Cirromulus/tuning-fork-clock/doc/face.jpg

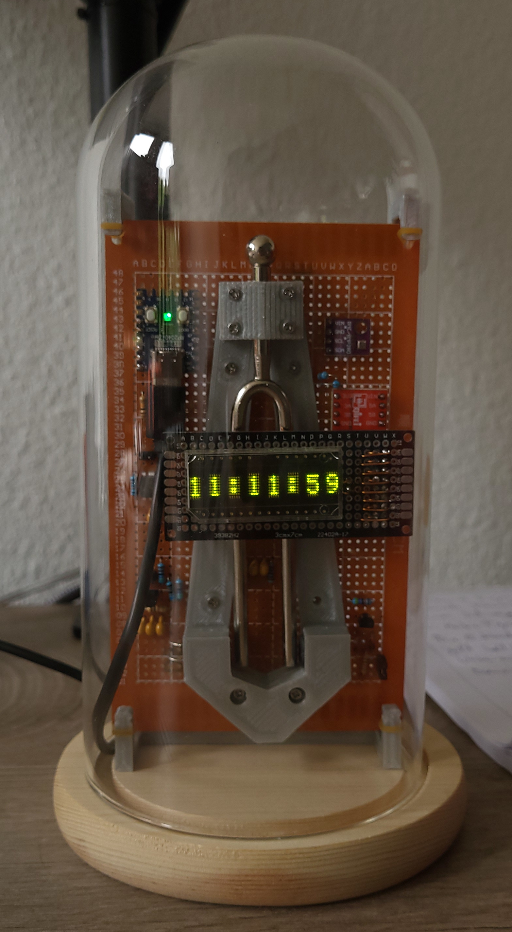
doc/face.jpg
