Cirromulus/tuning-fork-clock/doc/5_day_capture.png

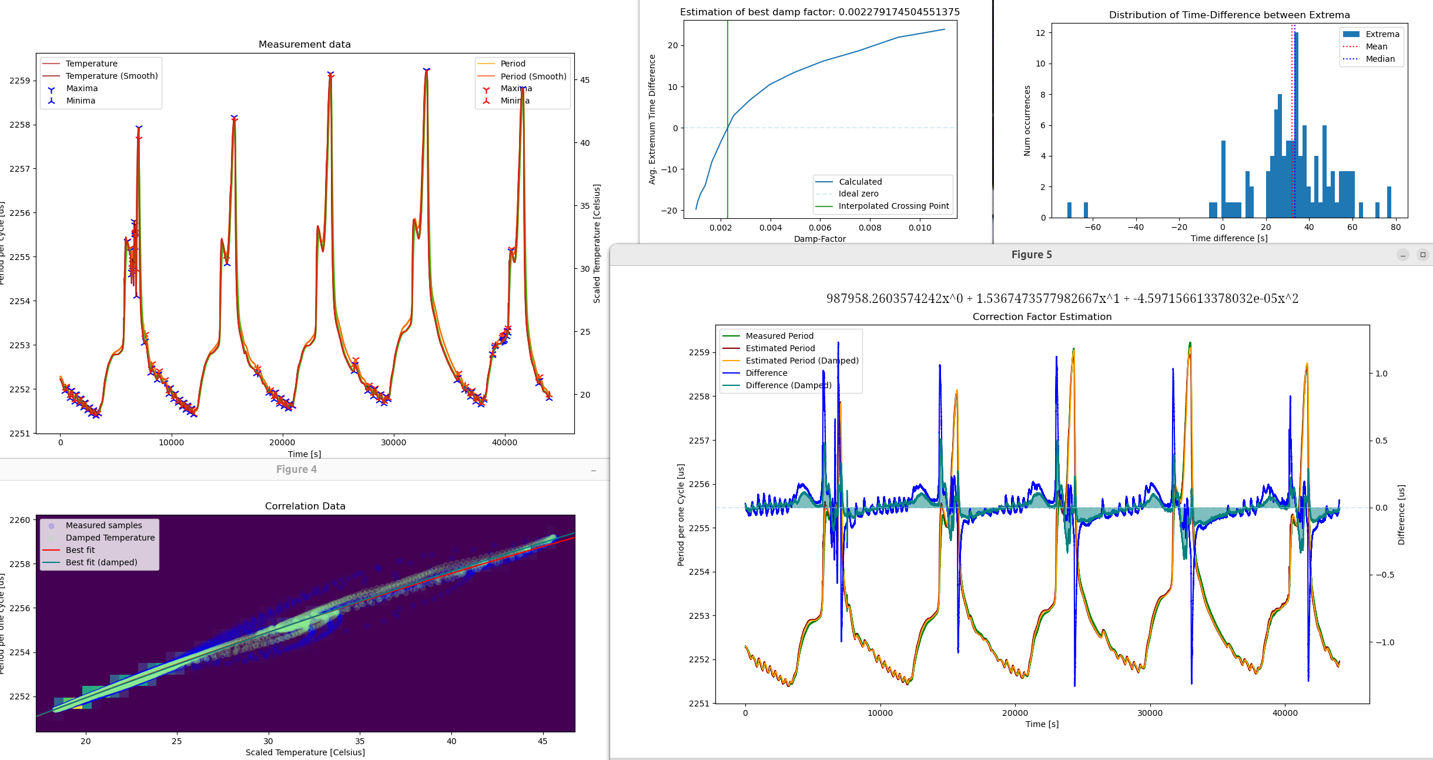
doc/5_day_capture.png
