Cirromulus/tuning-fork-clock/doc/model_training.png

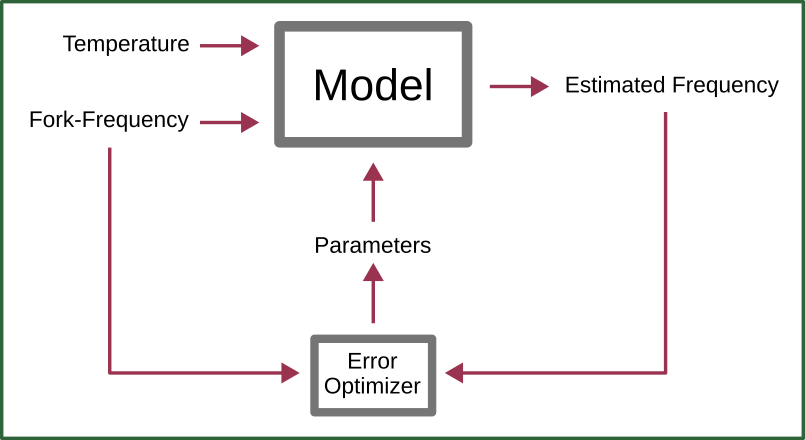
doc/model_training.png
