Cirromulus/tuning-fork-clock/model/Tuningforkholder_base.stl

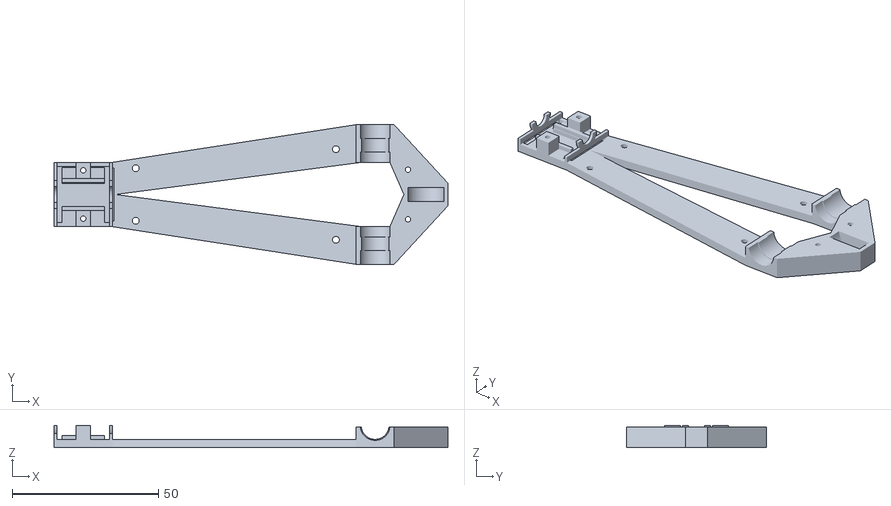
[picture p4: CAD file, 2026-03-09]
model/Tuningforkholder_base.stl
134.9 x 47.8 x 7.55
