Cirromulus/tuning-fork-clock/model/Tuningforkholder_all.stl

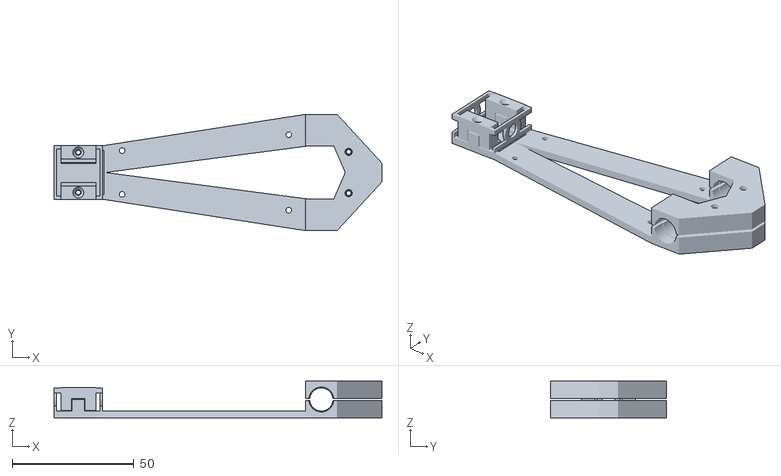
[picture p5: CAD file, 2026-03-09]
model/Tuningforkholder_all.stl
134.9 x 47.8 x 15.1
