Cirromulus/tuning-fork-clock/model/Tuningforkholder_top.stl

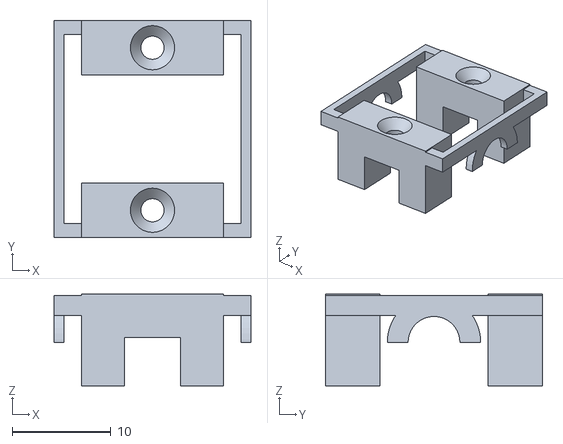
[picture p6: CAD file, 2026-03-09]
model/Tuningforkholder_top.stl
20.0 x 22.0 x 9.32
