Cirromulus/tuning-fork-clock/model/Baseplate_and_holder_normal.stl

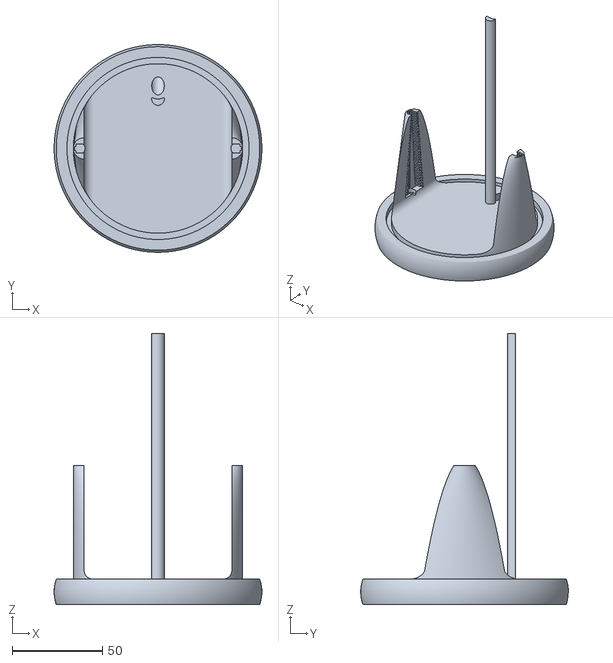
[picture p7: CAD file, 2025-11-26]
model/Baseplate_and_holder_normal.stl
115.0 x 114.9 x 150.0
