Cirromulus/tuning-fork-clock/model/Baseplate_and_holder_tpu.stl

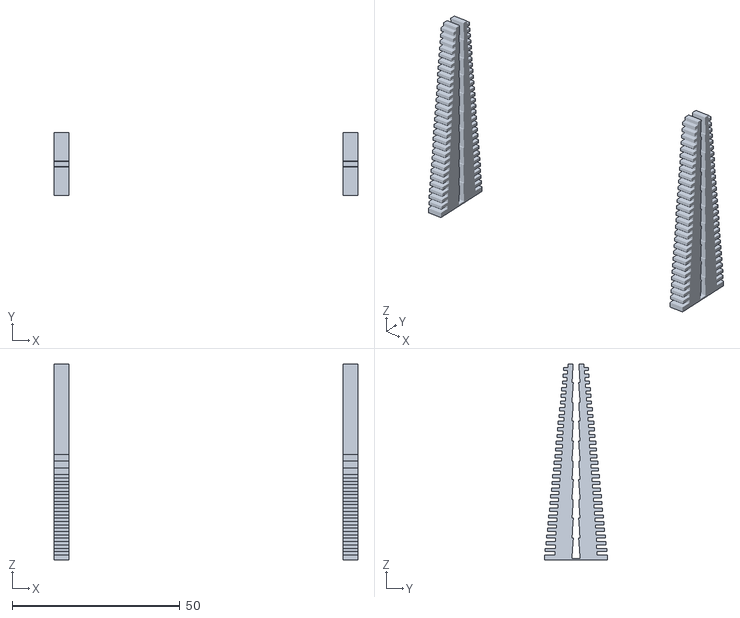
[picture p8: CAD file, 2025-11-26]
model/Baseplate_and_holder_tpu.stl
90.8 x 18.8 x 58.5
