Cirromulus/tuning-fork-clock/model/Stand_v2.FCStd

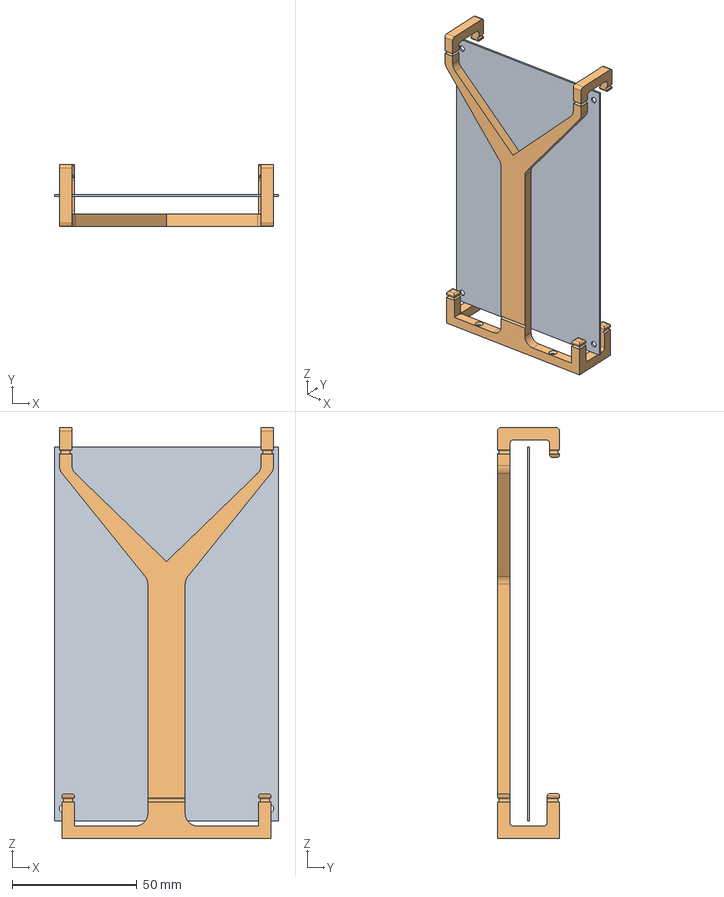
[picture p9: CAD file, 2025-05-02]
model/Stand_v2.FCStd
90.0 x 25.0 x 164.8 mm
Platine
Ständer
