Cirromulus/tuning-fork-clock/model/Stand_v2-Ständer.3mf

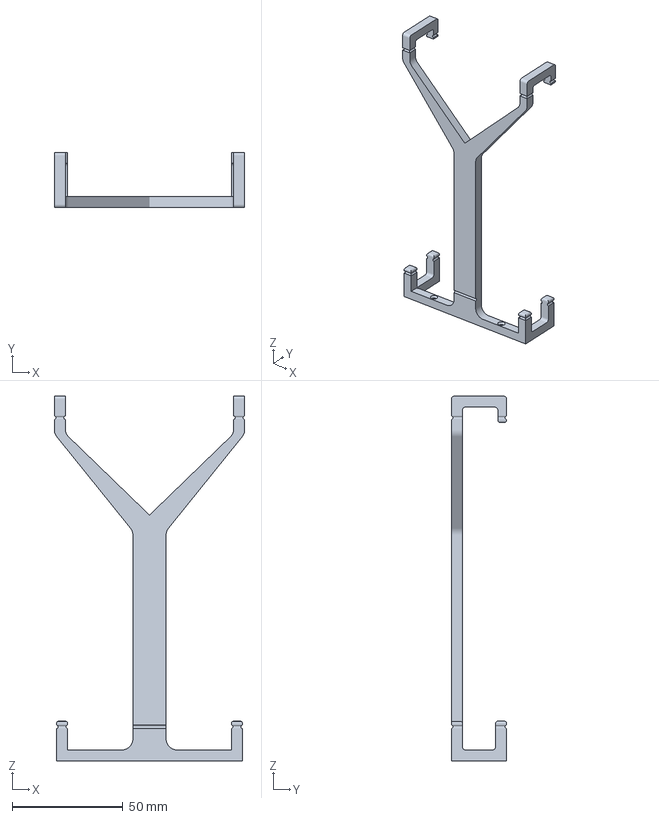
[picture p10: CAD file, 2025-04-27]
model/Stand_v2-Ständer.3mf
86.0 x 25.0 x 164.8 mm
