Cirromulus/tuning-fork-clock/model/Tuningforkholder_bottom.stl

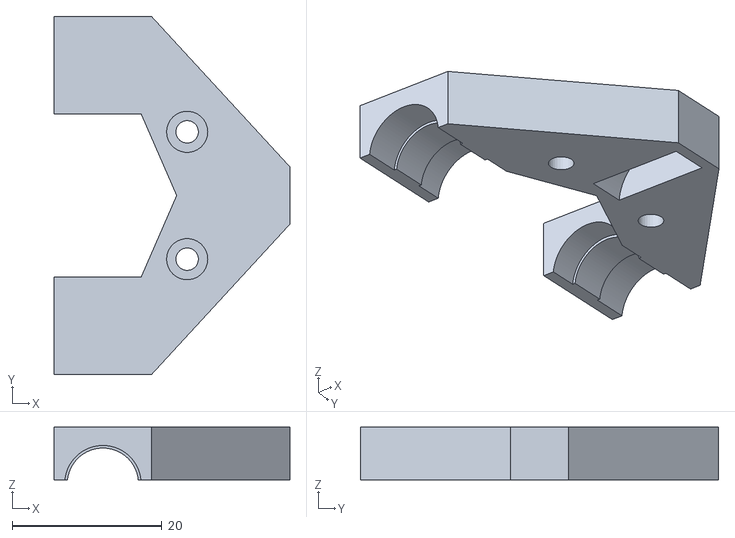
[picture p11: CAD file, 2025-03-22]
model/Tuningforkholder_bottom.stl
31.4 x 47.8 x 7.05
