Cirromulus/tuning-fork-clock/model/Stand.FCStd

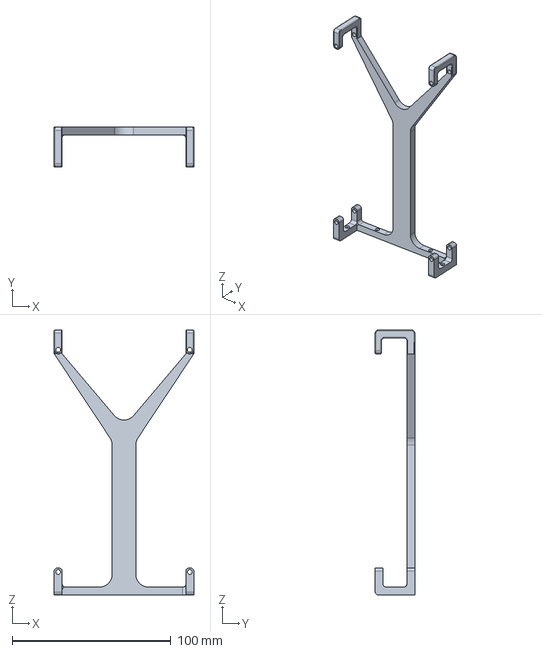
[picture p12: CAD file, 2025-03-30, an earlier design]
model/Stand.FCStd
88.0 x 25.0 x 167.0 mm
