Cirromulus/tuning-fork-clock/model/Tuningforkholder.scad

fork_abstand = 17;
fork_l = 123;
fork_arm_d = 5;
fork_hals_d = 5.5;
fork_hals_l = 40;
fork_hals_sphere = 9;
magnet = [12+.3,4.6+.3];
spule = [10.2, 9.5, 14];

screw_d = 2.1;
screw_head = [5.5, 0, 2];
ws = 1.4;
slot_h = 1;
mounting_height = magnet.x/2 + ws;
conn_h = 2*ws;
main_holder_extra_slit = .33;

show = "all";	//all, base, top, bottom

module fork() {
	round_part_h = ((fork_abstand-fork_hals_d)/2);
	translate([0,0,fork_hals_sphere/2]) {
		sphere(d = fork_hals_sphere);
		cylinder(d = fork_hals_d, h = fork_hals_l-fork_hals_sphere/2, $fn = $preview ? 30 : 80);
	}
	translate([0,0,fork_hals_l+round_part_h]) rotate([-90, 0, 0]) rotate_extrude(angle = 180) {
		translate([round_part_h, 0])circle(d = fork_hals_d);
	}
	for(x = [-round_part_h, round_part_h]) {
		translate([x, 0, fork_hals_l+round_part_h]) {
			cylinder(d = fork_arm_d, h = fork_l - fork_hals_l - round_part_h);
		}
	}
}

module translated_fork(){
translate([0, 0 , mounting_height]) rotate([90, 0, 90])
	fork();
}

module magnet(){
	$fn = $preview ? 30 : 80;
	color("grey")cylinder(d = magnet.x, h = magnet.y);
}

module translated_magnet(){
	translate([fork_l+magnet.x,-magnet.y/2, mounting_height]) rotate([0, 90, 90]) magnet();
}

module spule() {
	$fn = $preview ? 30 : 80;
	color("#809080") {
		cylinder(d = spule.y, h = spule.z);
		for(x = [0,2*spule.z/3]) translate([0, 0, x])
			cylinder(d = spule.x, h = spule.z/3);
	}
	for(x = [-spule.x/4, spule.x/4]) translate([x, 0, spule.z])
		cylinder(d = spule.y/6, h = 10);
}

module spule_array() {
	for(side = [1, -1]) {
		translate([fork_l-spule.x/2, side*(fork_abstand/2+ws), mounting_height])rotate([side*-90, 0, 0])spule();
	}
}

module screw(bite = true, l = 15, headsunk = false) {
	$fn = $preview ? 16 : 80;
	d = bite ? screw_d - .25 : screw_d + .25;
	translate([0,0,-(l-.01)])cylinder(d = d, h = l);
	cylinder(d1 = d, d2 = screw_head.x, h = screw_head.z + (headsunk ? l : 0));
	
}

%spule_array();
%translated_magnet();
%translated_fork();

holder_w = fork_hals_d * 4;
holder_l = fork_hals_l / 2; //(fork_hals_l-fork_hals_sphere)/2;
holder_anfang = fork_hals_sphere - 1;	// correction factor for where the spring holder actually would push against sphere
holder_cube_breit = holder_w/2 - fork_hals_d;

module main_holder_screws(bite = true) {
	for(x = [holder_l / 2] /*[holder_l/5, 4*holder_l/5]*/) {
		for(y = [-((holder_w - screw_head.x)/2), ((holder_w - screw_head.x)/2)]) {
			translate([holder_anfang + x, y, mounting_height+2*ws + fork_hals_d/2 - screw_head.z])
				screw(bite = bite);
		}
	}
}

spring_extra_dran = .25;
spring_d = 1;
module spring(mit_fuss = true)
{
	ws = 2;
	outer_diam = fork_hals_d + ws * 2;
	width = holder_w;
	mirror([0, 0, 1]) /* lol */ linear_extrude(spring_d)
	{
		if (mit_fuss)
		{
		square([ws*2, ws]);
		translate([0, holder_w - ws])
			square([ws*2, ws]);
		}
		translate([mounting_height, 0])
		{
			translate([-fork_hals_d / 2 - ws, 0])
				square([ws, holder_w]);
			translate([0, holder_w / 2])
			difference()
			{
				r = fork_hals_d / 2 + ws;
				circle(r, $fn = 50);
				translate([0, -(r+1)])
					square([r, (r*2)+1]);
				circle((fork_hals_d-spring_extra_dran)/2, $fn = 50);
			}
		}
	}
}

//module spring_negative()
//{
//	hull() spring();
//}

// main holder
module main_holder()
{
	difference() {
		translate([holder_anfang, -holder_w/2, 0])
		{
			// main plate
			cube([holder_l, holder_w, ws]);
			// side verstärkungen
			for (y  = [0, holder_w - ws])
			{
				translate([0, y, 0])
					cube([holder_l, ws, conn_h]);
			}
			// thing for screws and that keeps deckel somewhat in place (x)
			for (y  = [0, holder_w - holder_cube_breit])
			{
				dick = holder_l / 4;
				translate([holder_l/2 - dick/2, y, 0])
					cube([dick, holder_cube_breit, mounting_height]);
			}
			// thing that keeps deckel somewhat in place (y)
			block_x = holder_l - 4*ws;
			for (y  = [holder_cube_breit, (holder_w - holder_cube_breit) - ws])
			{
				translate([(holder_l - block_x)/2, y, ws])
					cube([block_x, ws, conn_h]);// need to be higher than the connector arms
			}
			// sockel oder so
			for (y  = [0, holder_w - block_x/2])
			{
				translate([(holder_l - block_x)/2, y, ws])
					cube([block_x, holder_cube_breit, ws]);
			}
			// spring parts
			for (x = [0, holder_l - spring_d])
			{
				translate([x, 0, 0])
				{
					rotate([0, -90, 0])
						spring();
				}
			}
		
		}
		#translated_fork();
		main_holder_screws();
		
	}
}

module deckel_main_holder()
{
	difference()
	{
		translate([holder_anfang, -holder_w/2, mounting_height])
		{
			for(x  = [0, holder_l - spring_d]) 
			{
				translate([x, 0, 0])
				{
					// UGLY!!!
					translate([0, 0, mounting_height])mirror([0, 0, 1])rotate([0, -90, 0])
						spring(false);
				}
			}
			uff_h = spring_d + 1;
			for(y = [0, holder_w - ws])
				translate([0, y, fork_hals_d / 2])
					cube([holder_l, ws, uff_h]);
			for (y  = [0, holder_w - holder_cube_breit])
			{
				dick = holder_l / 4 + 2*main_holder_extra_slit;
				hoch = mounting_height-2.8 - main_holder_extra_slit;
				block_x = holder_l - 4*ws;
				difference()
				{
					translate([(holder_l -block_x) / 2, y, -hoch])
						cube([block_x , holder_cube_breit, mounting_height + uff_h + .1 - main_holder_extra_slit]);
					translate([holder_l/2 - dick/2, y, -hoch ])
						cube([dick, holder_cube_breit, hoch+ 1.5 *main_holder_extra_slit]);	// 1.5 to have some slack with the screw.
				}
			}
		}
		main_holder_screws(bite = false);
	}
}

if(show == "all" || show == "base")
{
	main_holder();
}

// deckel main holder
if(show == "all" || show == "top")
	color("orange")
		deckel_main_holder();

// spule und magnet
sp_holder_l = spule.x + 2*ws;
sp_holder_w_clearance = 1;
sp_holder_w = spule.z;
mg_holder_l = magnet.x+2*ws;
start_holder_outside_y = (fork_abstand/2+ws) + sp_holder_w_clearance;

module spmg_holder() {
	for(side = [1,0]) {
		mirror([0,side, 0]) translate([fork_l,0,0]){
			// spule
			translate([-spule.x/2-sp_holder_l/2,start_holder_outside_y ,0]) {
				cube([sp_holder_l,sp_holder_w - sp_holder_w_clearance,mounting_height-slot_h/2]);
			}
			hull() {
				// short spule
				translate([0,start_holder_outside_y ,0]) {
					cube([ws,sp_holder_w - sp_holder_w_clearance,mounting_height-slot_h/2]);
				}
				//magnet
				translate([magnet.x-mg_holder_l/2,0, 0]) {
					cube([mg_holder_l,magnet.y/2+ws,mounting_height-slot_h/2]);
				}
			}
		}
	}
}

module spmg_screws(bite = true) {
	for(side = [1,0])
		mirror([0,side, 0]) 
			translate([fork_l+(magnet.x/2), fork_abstand/2, mounting_height+3*ws])
				screw(bite = bite, headsunk = !bite);
}

// spulemagnet holder
if(show == "all" || show == "base") difference() {
	spmg_holder();
	spule_array();
	translated_magnet();
	spmg_screws();
}

// spulemagnet deckel
if(show == "all" || show == "bottom") difference() {
	translate([0,0,mounting_height+slot_h/2])
		spmg_holder();
	spule_array();
	translated_magnet();
	spmg_screws(bite = false);
}

// connector arms
if(show == "all" || show == "base")
{
	for(side = [0, 1]) {
		mirror([0,side, 0])
		{
			difference() {
				hull() {
					// short spule
					translate([fork_l-sp_holder_l+ws,start_holder_outside_y ,0]) {
						cube([1,sp_holder_w - sp_holder_w_clearance,conn_h]);
					}
					translate([holder_anfang + holder_l,0,0])
						cube([1, holder_w/2, conn_h]);
				}
				translate([fork_l-sp_holder_l-screw_head.x, (fork_abstand+sp_holder_w)/2, conn_h])
					screw(bite = false);
				magic_offs = [1.5, .5];	// To make it align to the raster of my platine
				translate([fork_hals_l-screw_head.x+magic_offs.x, fork_abstand/2+magic_offs.y, conn_h])
					screw(bite = false);
				main_holder_screws();
				for (x = [0, holder_l - spring_d])
				{
					translate([holder_anfang-0.5 + x, -holder_w/2 + ws, ws])
						cube([spring_d + 1, holder_w - (ws+spring_d * 2), ws]);
				}
			}
		}
	}
}
