Cirromulus/tuning-fork-clock/doc/analysis_results.png

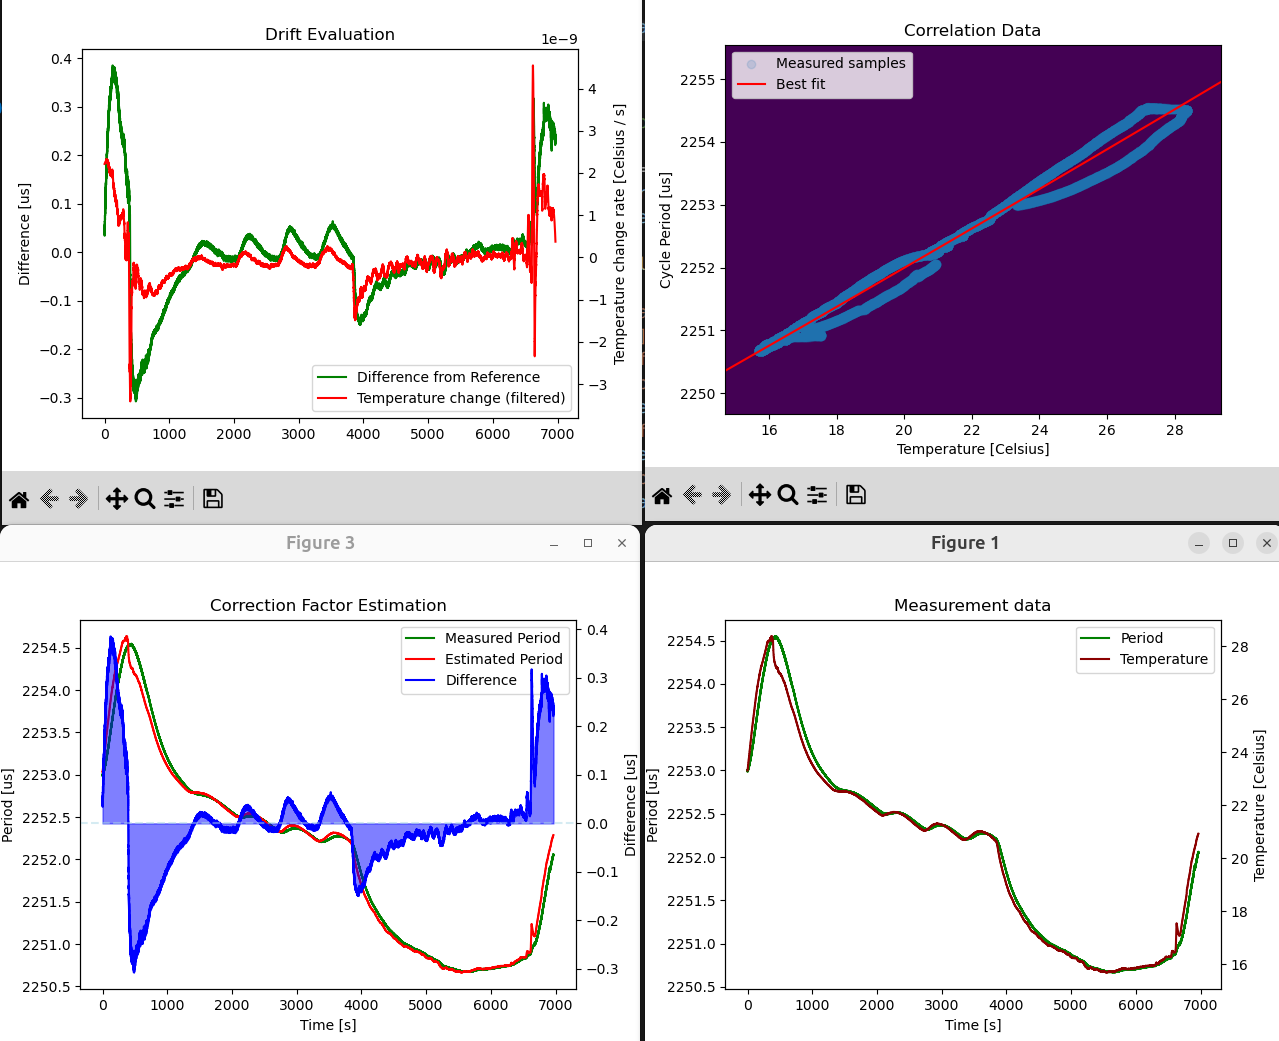
doc/analysis_results.png
