Cirromulus/tuning-fork-clock/Inspiration/Tuning Fork Clock.pdf

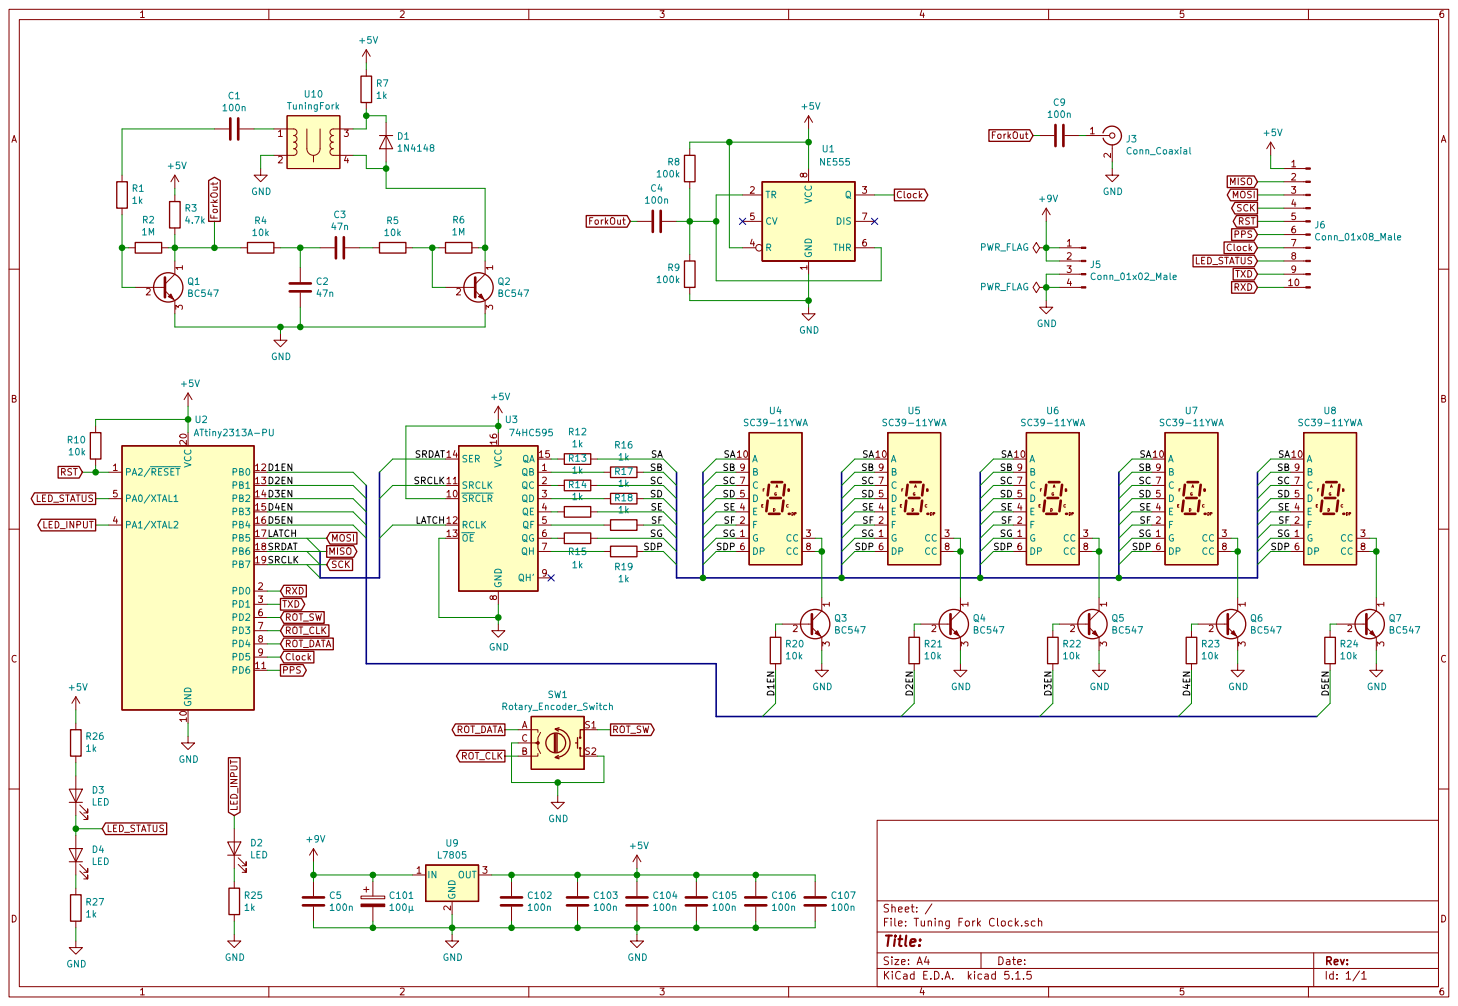
[picture p14: page 1]

3 Q4BC547 QB 1 SRCLR 10 SRCLK 11 RCLK 12 OE 13 SER 14 QA 15 VCC 16 QC 2 QD 3 QE 4 QF 5 QG 6 QH 7 GND

File: Tuning Fork Clock.sch Sheet: /
Id: 1/1 Title:
