Cirromulus/tuning-fork-clock/pcb/ptf.kicad_pcb

## KiCad design pcb/ptf.kicad_pcb (2022-12-27)

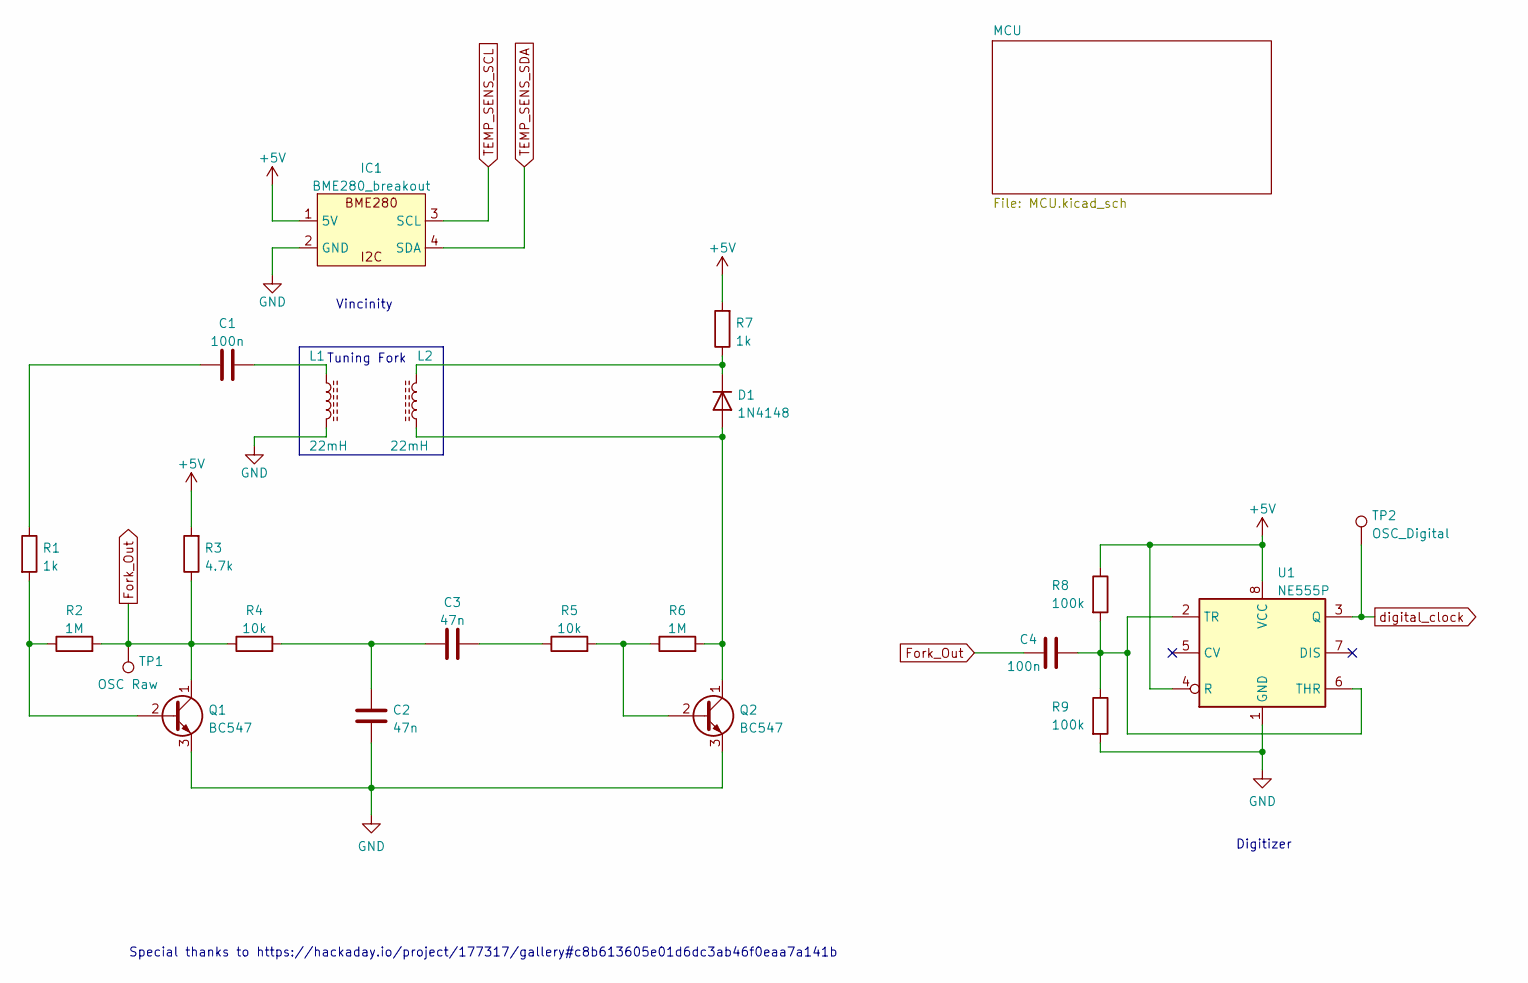
[picture p15: schematic ptf.kicad_sch]

Parts:
C1, C4: 100n; C_Disc_D4.7mm_W2.5mm_P5.00mm
C2, C3: 47n; C_Disc_D4.7mm_W2.5mm_P5.00mm
D1: 1N4148; D_DO-35_SOD27_P7.62mm_Horizontal
IC1: BME280_breakout; PinHeader_1x04_P2.54mm_Vertical
L1, L2: 22mH; L_Radial_D7.8mm_P5.00mm_Fastron_07HCP
Q1, Q2: BC547; TO-92_Inline
R1, R7: 1k; R_Axial_DIN0309_L9.0mm_D3.2mm_P12.70mm_Horizontal
R2, R6: 1M; R_Axial_DIN0309_L9.0mm_D3.2mm_P12.70mm_Horizontal
R3: 4.7k; R_Axial_DIN0309_L9.0mm_D3.2mm_P12.70mm_Horizontal
R4, R5: 10k; R_Axial_DIN0309_L9.0mm_D3.2mm_P12.70mm_Horizontal
R8, R9: 100k; R_Axial_DIN0309_L9.0mm_D3.2mm_P12.70mm_Horizontal
TP1: OSC Raw; TestPoint_Pad_D1.5mm
TP2: OSC_Digital; TestPoint_Pad_D1.5mm
U1: NE555P; DIP-8_W7.62mm

Connections:
+5V: IC1.1 (5V), R3.2, R7.2, R8.1, U1.4 (R), U1.8 (VCC); also elsewhere on the board
Fork_Out: C4.1, Q1.1 (C), R2.2, R3.1, R4.1, TP1.1
GND: C2.1, IC1.2 (GND), L1.2, Q1.3 (E), Q2.3 (E), R9.2, U1.1 (GND); also elsewhere on the board
unnamed: C1.1, R1.1
unnamed: C1.2, L1.1
unnamed: C2.2, C3.1, R4.2
unnamed: C3.2, R5.1
unnamed: D1.1 (K), L2.2, R7.1
unnamed: D1.2 (A), L2.1, Q2.1 (C), R6.2
unnamed: Q1.2 (B), R1.2, R2.1
unnamed: Q2.2 (B), R5.2, R6.1
unnamed: C4.2, R8.2, R9.1, U1.2 (TR), U1.6 (THR)
SCL: IC1.3 (SCL); also elsewhere on the board
SDA: IC1.4 (SDA); also elsewhere on the board
digital_clock: TP2.1, U1.3 (Q); also elsewhere on the board

Notes on the sheet:
Tuning Fork
Digitizer
Vincinity
Special thanks to https://hackaday.io/project/177317/gallery#c8b613605e01d6dc3ab46f0eaa7a141b

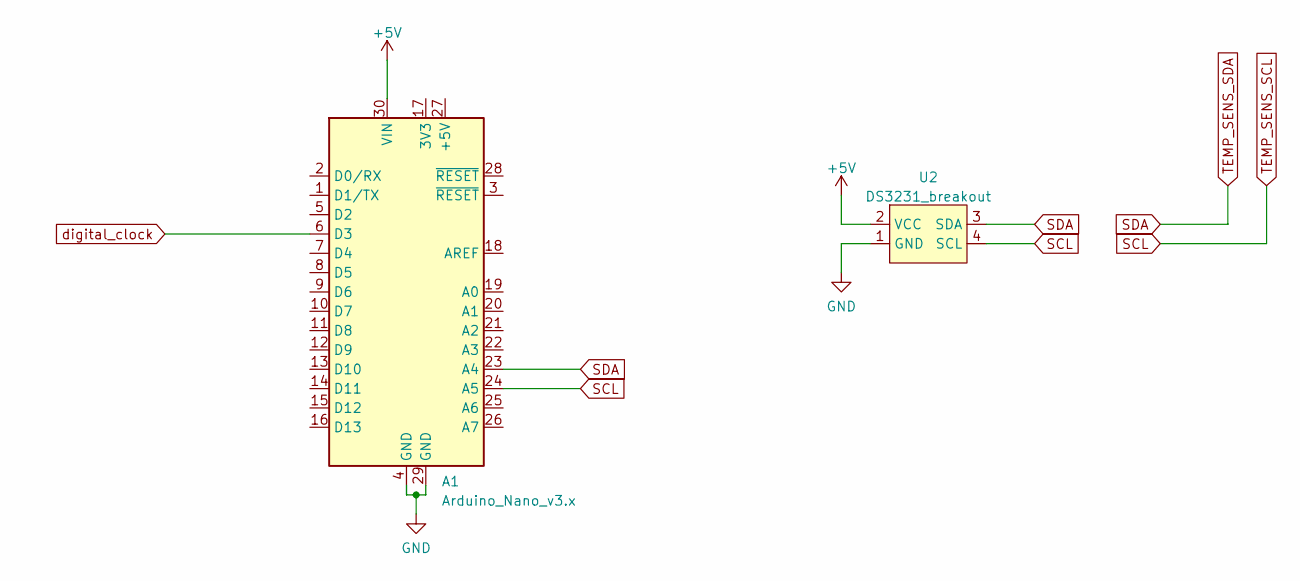
[picture p16: schematic MCU.kicad_sch]

Parts:
A1: Arduino_Nano_v3.x; Arduino_Nano
U2: DS3231_breakout; PinHeader_1x04_P2.54mm_Vertical

Connections:
+5V: A1.30 (VIN), U2.2 (VCC); also elsewhere on the board
GND: A1.4 (GND), A1.29 (GND), U2.1 (GND); also elsewhere on the board
SCL: A1.24 (A5), U2.4 (SCL); also elsewhere on the board
SDA: A1.23 (A4), U2.3 (SDA); also elsewhere on the board
digital_clock: A1.6 (D3); also elsewhere on the board

Board: 2 copper layers, 24 parts (1 on the bottom side), 15 nets, no tracks yet.
