Cirromulus/tuning-fork-clock/(commit log)

2025-03-22 Switched Pin, seems to count correctly, added bigger average
    [config.hpp, main.cpp]
2025-03-22 Period instead of frequency for a higher resolution
    [Anschwingverhalten.csv]
2025-03-22 Added I2C bus scan. Perhaps I fried the sensor with 5v
2025-03-22 Using beefier coils made it work
    [Tuningforkholder.scad, Tuningforkholder_all.stl, Tuningforkholder_base.stl, Tuningforkholder_bottom.stl, Tuningforkholder_top.stl]
2025-03-22 (perhaps) More clearance for coils and (perhaps) better aligned holes for lochrasterplatine
    [Tuningforkholder.scad, Tuningforkholder_all.stl, Tuningforkholder_base.stl, Tuningforkholder_bottom.stl, Tuningforkholder_top.stl]
2025-03-22 added temp sensor datasheet
2025-03-22 Found out that all (my or in general?) SHT20 did not respond to i2c, so switching to BMP280
2025-03-22 First impressions with temperature sensor
2025-03-23 Did not manage to get it measuring correctly
    [main.cpp]
2025-03-23 Added LED output
2025-03-27 Added no-signal led
2025-03-27 Found out that calibration values are differently byte ordered as the sensor values
2025-03-27 Temp and Humid seem plausible, pressure not really
2025-03-30 Able to obtain correction function and plotting that
    [plot.py]
2025-03-30 Perhaps calculating correctly the hypothetical drift
    [plot.py]
2025-03-30 Could correlate temperature change rate with error
    [plot.py]
2025-03-30 Forgot adding model. Needs some improvements, though.
    [Stand.FCStd]
2025-03-31 Making mis-sensored values less likely
2025-04-05 Using and printing damped temperature
2025-04-08 Noticed that optimization is targeting period, not long term drift
    [plot.py]
2025-04-11 Introduced temperature change compensation, does not do much
2025-04-14 Medium-term measurement in basement with controlled heat that one time
2025-04-25 Simple print of elapsed seconds
2025-04-25 Quick hagg to also show drift
    [main.cpp]
2025-04-27 Added slightly updated version.
    [Stand_v2-Ständer.3mf, Stand_v2.FCStd]
2025-04-27 Improved Rubber Band slots
    [Stand_v2-Ständer.3mf, Stand_v2.FCStd]
2025-05-01 Untested version of running text
    [Anschwingverhalten.csv]
2025-05-02 Added basic command handler
    [Stand_v2.FCStd]
2025-05-02 Fixed fade_in on smaller string
    [command.hpp]
2025-05-03 Showing drift since absolute time set
    [absolute_time.hpp, command.hpp, config.hpp, display.hpp, main.cpp, reference_tick.cpp, reference_tick.hpp]
2025-05-09 Does not care for input currently\!\?
2025-05-10 Added TODO for average correct value of pulse counter
    [reference_tick.hpp]
2025-05-11 It actually counts from external oscillator!
    [config.hpp, display.hpp, main.cpp, tests.hpp]
2025-05-12 Fixup: Resetting PIO interrupt on wrap
    [config.hpp, data.py, log.py, reference_tick.hpp]
2025-05-13 Fixed showError duration bug if string is <= display size
    [main.cpp]
2025-05-14 Added better error logging for temperature sensor
    [ddf.cpp, main.cpp]
2025-05-15 Showing measured temperature as well
2025-06-04 Added TODO as I encountered an "got default value" error of BME
    [main.cpp]
2025-06-11 Added bme re-init after read fail
    [main.cpp]
2025-07-23 Fixed spurious missing reference clock count by increasing timeout
    [command.hpp, main.cpp, reference_tick.hpp]
2025-07-23 Corrected estimation error plot
    [plot.py]
2025-07-27 Got fooled by myself. Reducing Display brightness to reduce (uneven) heat production in Käseglocke
2025-08-11 Re-Run calibration on less display-heat distracted run
2025-08-12 Added drift evaluation and corrected sample time calculation
    [estimate.py]
2025-08-31 Settime now works via UART
2025-09-17 Added smoothed drift to plot for analysis
    [plot.py]
2025-09-24 Quick and dirty fix for intermittent biterrors in serial character readout
    [command.hpp, main.cpp, settime.py]
2025-11-02 Found my problem: The GPS-Receiver was reset and did a too-slow reference clock!
    [main.cpp, reference_tick.hpp, tests.hpp]
2025-11-21 Added Poor-mans single-ended diff pair feature by GPIO-grounding an adjacent pin
2025-11-21 Jump-Start Fork by outputting expected frequency. Currently non-functional because the NE555 stops that
2025-11-21 Initial draft of new base + holder combi
    [Baseplate_and_holder.scad]
2025-11-21 added cable slot
    [Baseplate_and_holder.scad]
2025-11-21 Halber weg zu dual material
    [Baseplate_and_holder.scad]
2025-11-22 Some kind of sawtooth to softly grip the plate
    [Baseplate_and_holder.scad]
2025-11-22 Fits in Glass, actually
    [Baseplate_and_holder.scad]
2025-11-24 Test shows that it is too coupled in z direction
    [Baseplate_and_holder.scad]
2025-11-24 Nicer Stair multiple rest bla
    [Baseplate_and_holder.scad]
2025-11-25 More sturdy Holder with hopefully less contact
    [Baseplate_and_holder.scad]
2025-11-25 Minor adaptations. Is being printed like that.
    [Baseplate_and_holder.scad]
2025-11-26 Needs slightly more pressure, but is loud anyway
    [Baseplate_and_holder.scad, Baseplate_and_holder_normal.stl, Baseplate_and_holder_tpu.stl]
2026-03-08 Starting spring-decoupled mount for fork to reduce noise and damping (not yet good)
    [Tuningforkholder.scad, Tuningforkholder_all.stl, Tuningforkholder_base.stl, Tuningforkholder_top.stl]
2026-03-08 Might actually work. Sounds undamped and holds more or less. Idea with Zipties is not working, though.
    [Tuningforkholder.scad, Tuningforkholder_all.stl, Tuningforkholder_base.stl, Tuningforkholder_top.stl]
2026-03-09 resting on sphere might work.
    [Tuningforkholder.scad, Tuningforkholder_all.stl, Tuningforkholder_base.stl, Tuningforkholder_top.stl]
2026-03-09 A little more force on the hals
    [Tuningforkholder.scad, Tuningforkholder_all.stl, Tuningforkholder_base.stl, Tuningforkholder_top.stl]
2026-03-10 fixup! added cable slot
2026-04-01 Quick correction for time
    [config.hpp, estimate.py, log.py, settime.py]
2026-06-10 Using internal clock for display drift string
    [estimate.py, main.cpp, reference_tick.cpp]
2026-06-10 Faster error display to loose less time. This is just a band-aid to a different problem.
    [display.hpp]
2026-06-26 Investigating temperature measurement problem
    [config.hpp, ddf.cpp, main.cpp]
